TeamPracticalProjects/Tiny_Sensor/Documents/Tiny_Sensor_Schematic v1.pdf

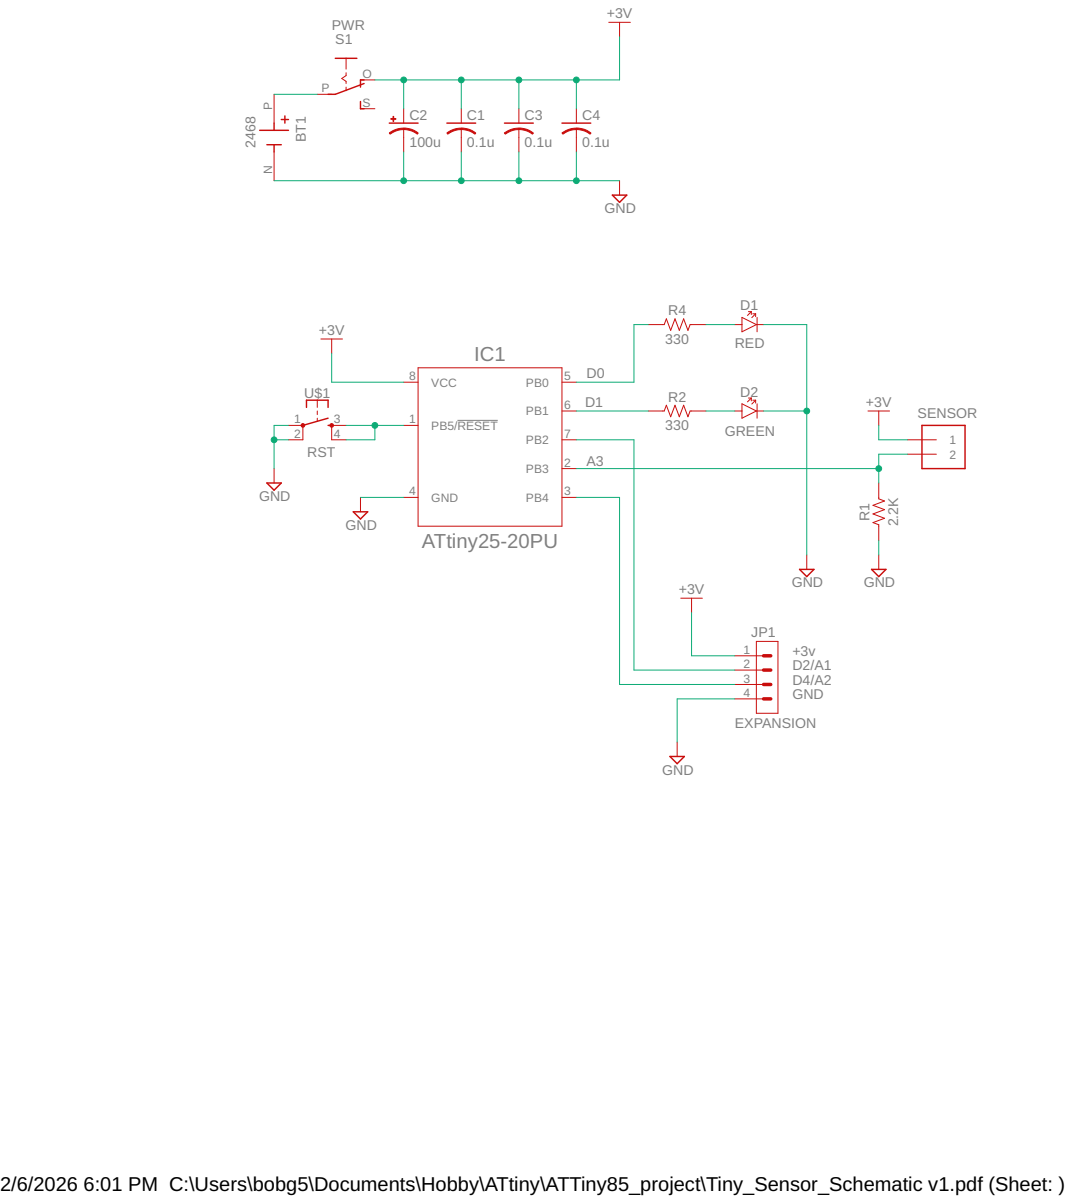
[picture p5: page 1]

2/6/2026 6:01 PM C:\Users\bobg5\Documents\Hobby\ATtiny\ATTiny85_project\Tiny_Sensor_Schematic v1.pdf (Sheet: )
